dgerb/PicrogridE/README.md

# Picrogrid
Repository for Picrogrid Raspberry Pi code and scripts and Atverter Arduino code
