dgerb/PicrogridE/AtverterE/KiCad/Projects/Atverter_vE1r5/Atverter_vE1r5.kicad_pcb

## KiCad design AtverterE/KiCad/Projects/Atverter_vE1r5/Atverter_vE1r5.kicad_pcb (2022-10-17)

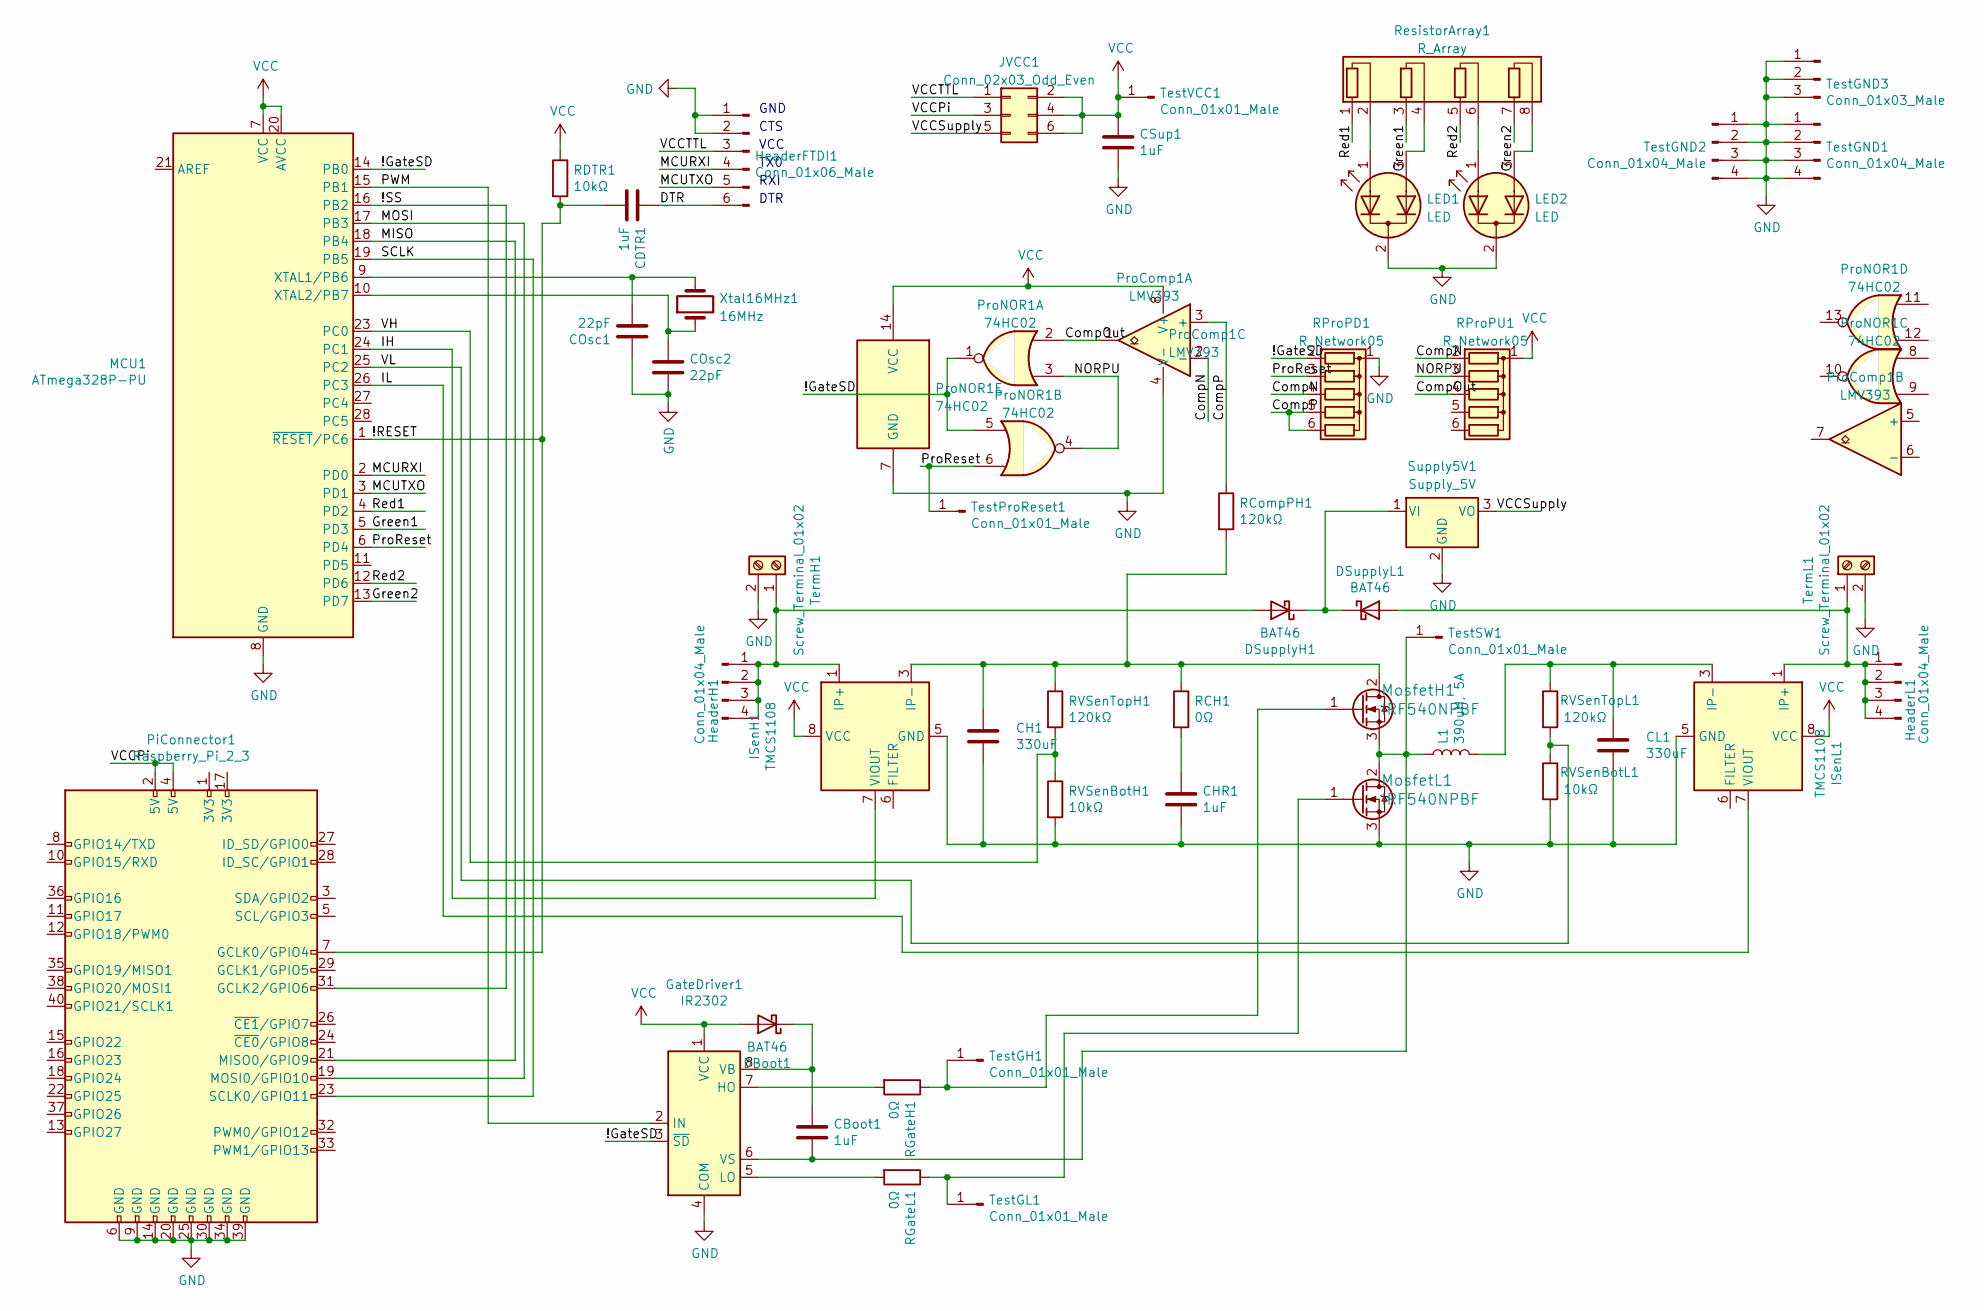
[picture p1: schematic Atverter_vE1r5.kicad_sch]

Parts:
CBoot1: 1uF; C_Rect_L7.2mm_W3.5mm_P5.00mm_FKS2_FKP2_MKS2_MKP2
CDTR1: 1uF; C_Rect_L7.2mm_W3.5mm_P5.00mm_FKS2_FKP2_MKS2_MKP2
CH1: 330uF; CP_Radial_D18.0mm_P7.50mm
CHR1: 1uF; C_Rect_L7.2mm_W3.5mm_P5.00mm_FKS2_FKP2_MKS2_MKP2
CL1: 330uF; CP_Radial_D18.0mm_P7.50mm
COsc1, COsc2: 22pF; C_Rect_L7.2mm_W3.5mm_P5.00mm_FKS2_FKP2_MKS2_MKP2
CSup1: 1uF; C_Rect_L7.2mm_W3.5mm_P5.00mm_FKS2_FKP2_MKS2_MKP2
DBoot1: BAT46; D_DO-35_SOD27_P7.62mm_Horizontal
DSupplyH1: BAT46; D_DO-35_SOD27_P7.62mm_Horizontal
DSupplyL1: BAT46; D_DO-35_SOD27_P7.62mm_Horizontal
GateDriver1: IR2302; DIP-8_W7.62mm_LongPads
HeaderFTDI1: Conn_01x06_Male; FTDI_USB_TTL_Header
HeaderH1: Conn_01x04_Male; PinHeader_1x04_P2.54mm_Vertical
HeaderL1: Conn_01x04_Male; PinHeader_1x04_P2.54mm_Vertical
ISenH1: TMCS1108; SOIC-8_3.9x4.9mm_P1.27mm
ISenL1: TMCS1108; SOIC-8_3.9x4.9mm_P1.27mm
JVCC1: Conn_02x03_Odd_Even; PinHeader_2x03_P2.54mm_Vertical
L1: 390uH, 5A; L_Toroid_Horizontal_D32.5mm_P30.00mm_Bourns_2300
LED1, LED2: LED; LED_3pin_P2.54mm
MCU1: ATmega328P-PU; DIP-28_W7.62mm
MosfetH1: IRF540NPBF; TO-220-3_Vertical; MPN IRF540NPBF; Digi-Key_PN IRF540NPBF-ND
MosfetL1: IRF540NPBF; TO-220-3_Vertical; MPN IRF540NPBF; Digi-Key_PN IRF540NPBF-ND
PiConnector1: Raspberry_Pi_2_3; Raspberry_Pi_Zero_and_Four
ProComp1: LMV393; DIP-8_W7.62mm_LongPads
ProNOR1: 74HC02; DIP-14_W7.62mm_LongPads
RCH1: 0Ω; R_Axial_DIN0207_L6.3mm_D2.5mm_P7.62mm_Horizontal
RCompPH1: 120kΩ; R_Axial_DIN0207_L6.3mm_D2.5mm_P7.62mm_Horizontal
RDTR1: 10kΩ; R_Axial_DIN0207_L6.3mm_D2.5mm_P7.62mm_Horizontal
RGateH1: 0Ω; R_Axial_DIN0207_L6.3mm_D2.5mm_P7.62mm_Horizontal
RGateL1: 0Ω; R_Axial_DIN0207_L6.3mm_D2.5mm_P7.62mm_Horizontal
RProPD1: R_Network05; R_Array_SIP6
RProPU1: R_Network05; R_Array_SIP6
RVSenBotH1: 10kΩ; R_Axial_DIN0207_L6.3mm_D2.5mm_P7.62mm_Horizontal
RVSenBotL1: 10kΩ; R_Axial_DIN0207_L6.3mm_D2.5mm_P7.62mm_Horizontal
RVSenTopH1: 120kΩ; R_Axial_DIN0207_L6.3mm_D2.5mm_P7.62mm_Horizontal
RVSenTopL1: 120kΩ; R_Axial_DIN0207_L6.3mm_D2.5mm_P7.62mm_Horizontal
ResistorArray1: R_Array; R_Array_SIP8
Supply5V1: Supply_5V; SupplyDC_48V-5V_TO-220-3_Vertical
TermH1: Screw_Terminal_01x02; Term_Block_1x2_P5mm
TermL1: Screw_Terminal_01x02; Term_Block_1x2_P5mm
TestGH1: Conn_01x01_Male; PinHeader_1x01_P2.54mm_Vertical
TestGL1: Conn_01x01_Male; PinHeader_1x01_P2.54mm_Vertical
TestGND1, TestGND2: Conn_01x04_Male; PinHeader_1x04_P2.54mm_Vertical
TestGND3: Conn_01x03_Male; PinHeader_1x03_P2.54mm_Vertical
TestProReset1: Conn_01x01_Male; PinHeader_1x01_P2.54mm_Vertical
TestSW1: Conn_01x01_Male; PinHeader_1x01_P2.54mm_Vertical
TestVCC1: Conn_01x01_Male; PinHeader_1x01_P2.54mm_Vertical
Xtal16MHz1: 16MHz; Resonator-2Pin_W10.0mm_H5.0mm

Connections:
/!GateSD: GateDriver1.3 (~SD), MCU1.14 (PB0), ProNOR1.1, ProNOR1.5, RProPD1.2 (R1)
/!RESET: CDTR1.2, MCU1.1 (~RESET/PC6), PiConnector1.7 (GCLK0/GPIO4), RDTR1.2
/!SS: MCU1.16 (PB2), PiConnector1.31 (GCLK2/GPIO6)
/CompN: ProComp1.2 (-), RProPD1.4 (R3), RProPU1.2 (R1)
/CompOut: ProComp1.1, ProNOR1.2, RProPU1.4 (R3)
/CompP: ProComp1.3 (+), RCompPH1.1, RProPD1.5 (R4), RProPD1.6 (R5); also elsewhere on the board
/DTR: CDTR1.1, HeaderFTDI1.6
/Green1: MCU1.5 (PD3), ResistorArray1.3 (R2.1)
/Green2: MCU1.13 (PD7), ResistorArray1.7 (R4.1)
/IH: ISenH1.7 (VIOUT), MCU1.24 (PC1)
/IL: ISenL1.7 (VIOUT), MCU1.26 (PC3)
/MCURXI: HeaderFTDI1.4, MCU1.2 (PD0)
/MCUTXO: HeaderFTDI1.5, MCU1.3 (PD1)
/MISO: MCU1.18 (PB4), PiConnector1.21 (MISO0/GPIO9)
/MOSI: MCU1.17 (PB3), PiConnector1.19 (MOSI0/GPIO10)
/NORPU: ProNOR1.3, ProNOR1.4, RProPU1.3 (R2)
/PWM: GateDriver1.2 (IN), MCU1.15 (PB1)
/ProReset: MCU1.6 (PD4), ProNOR1.6, RProPD1.3 (R2), TestProReset1.1
/Red1: MCU1.4 (PD2), ResistorArray1.1 (R1.1)
/Red2: MCU1.12 (PD6), ResistorArray1.5 (R3.1)
/SCLK: MCU1.19 (PB5), PiConnector1.23 (SCLK0/GPIO11)
/VCCPi: JVCC1.3, PiConnector1.2 (5V), PiConnector1.4 (5V)
/VCCSupply: JVCC1.5, Supply5V1.3 (VO)
/VCCTTL: HeaderFTDI1.3, JVCC1.1
/VH: MCU1.23 (PC0), RVSenBotH1.1, RVSenTopH1.2
/VL: MCU1.25 (PC2), RVSenBotL1.1, RVSenTopL1.2
GND: CH1.2, CHR1.2, CL1.2, COsc1.1, COsc2.2, CSup1.2, GateDriver1.4 (COM), HeaderFTDI1.1, HeaderFTDI1.2, ISenH1.5 (GND), ISenL1.5 (GND), LED1.2 (K), LED2.2 (K), MCU1.8 (GND), MCU1.22 (GND), MosfetL1.3 (S), PiConnector1.6 (GND), PiConnector1.9 (GND), PiConnector1.14 (GND), PiConnector1.20 (GND), PiConnector1.25 (GND), PiConnector1.30 (GND), PiConnector1.34 (GND), PiConnector1.39 (GND), ProComp1.4 (V-), ProNOR1.7 (GND), RProPD1.1 (common), RVSenBotH1.2, RVSenBotL1.2, Supply5V1.2 (GND), TermH1.2, TermL1.2, TestGND1.1, TestGND1.2, TestGND1.3, TestGND1.4, TestGND2.1, TestGND2.2, TestGND2.3, TestGND2.4, TestGND3.1, TestGND3.2, TestGND3.3
unnamed: CBoot1.1, DBoot1.1 (K), GateDriver1.8 (VB)
unnamed: CBoot1.2, GateDriver1.6 (VS), L1.1, MosfetH1.3 (S), MosfetL1.2 (D), TestSW1.1
unnamed 29: CH1.1, ISenH1.3 (IP-), ISenH1.4 (IP-), MosfetH1.2 (D), RCH1.1, RCompPH1.2, RVSenTopH1.1; also elsewhere on the board
unnamed: CHR1.1, RCH1.2
unnamed: CL1.1, ISenL1.3 (IP-), ISenL1.4 (IP-), L1.2, RVSenTopL1.1
unnamed: COsc1.2, MCU1.9 (XTAL1/PB6), Xtal16MHz1.2
unnamed: COsc2.1, MCU1.10 (XTAL2/PB7), Xtal16MHz1.1
unnamed: DSupplyH1.1 (K), DSupplyL1.1 (K), Supply5V1.1 (VI)
unnamed: DSupplyH1.2 (A), HeaderH1.1, HeaderH1.2, HeaderH1.3, HeaderH1.4, ISenH1.1 (IP+), ISenH1.2 (IP+), TermH1.1
unnamed: DSupplyL1.2 (A), HeaderL1.1, HeaderL1.2, HeaderL1.3, HeaderL1.4, ISenL1.1 (IP+), ISenL1.2 (IP+), TermL1.1
unnamed: GateDriver1.5 (LO), RGateL1.2
unnamed: GateDriver1.7 (HO), RGateH1.2
unnamed: LED1.1 (A1), ResistorArray1.2 (R1.2)
unnamed: LED1.3 (A2), ResistorArray1.4 (R2.2)
unnamed: LED2.1 (A1), ResistorArray1.6 (R3.2)
unnamed: LED2.3 (A2), ResistorArray1.8 (R4.2)
unnamed: MosfetH1.1 (G), RGateH1.1, TestGH1.1
unnamed: MosfetL1.1 (G), RGateL1.1, TestGL1.1
VCC: CSup1.1, DBoot1.2 (A), GateDriver1.1 (VCC), ISenH1.8 (VCC), ISenL1.8 (VCC), JVCC1.2, JVCC1.4, JVCC1.6, MCU1.7 (VCC), MCU1.20 (AVCC), ProComp1.8 (V+), ProNOR1.14 (VCC), RDTR1.1, RProPU1.1 (common), TestVCC1.1

Notes on the sheet:
RXI
GND
VCC
TX0
DTR
CTS

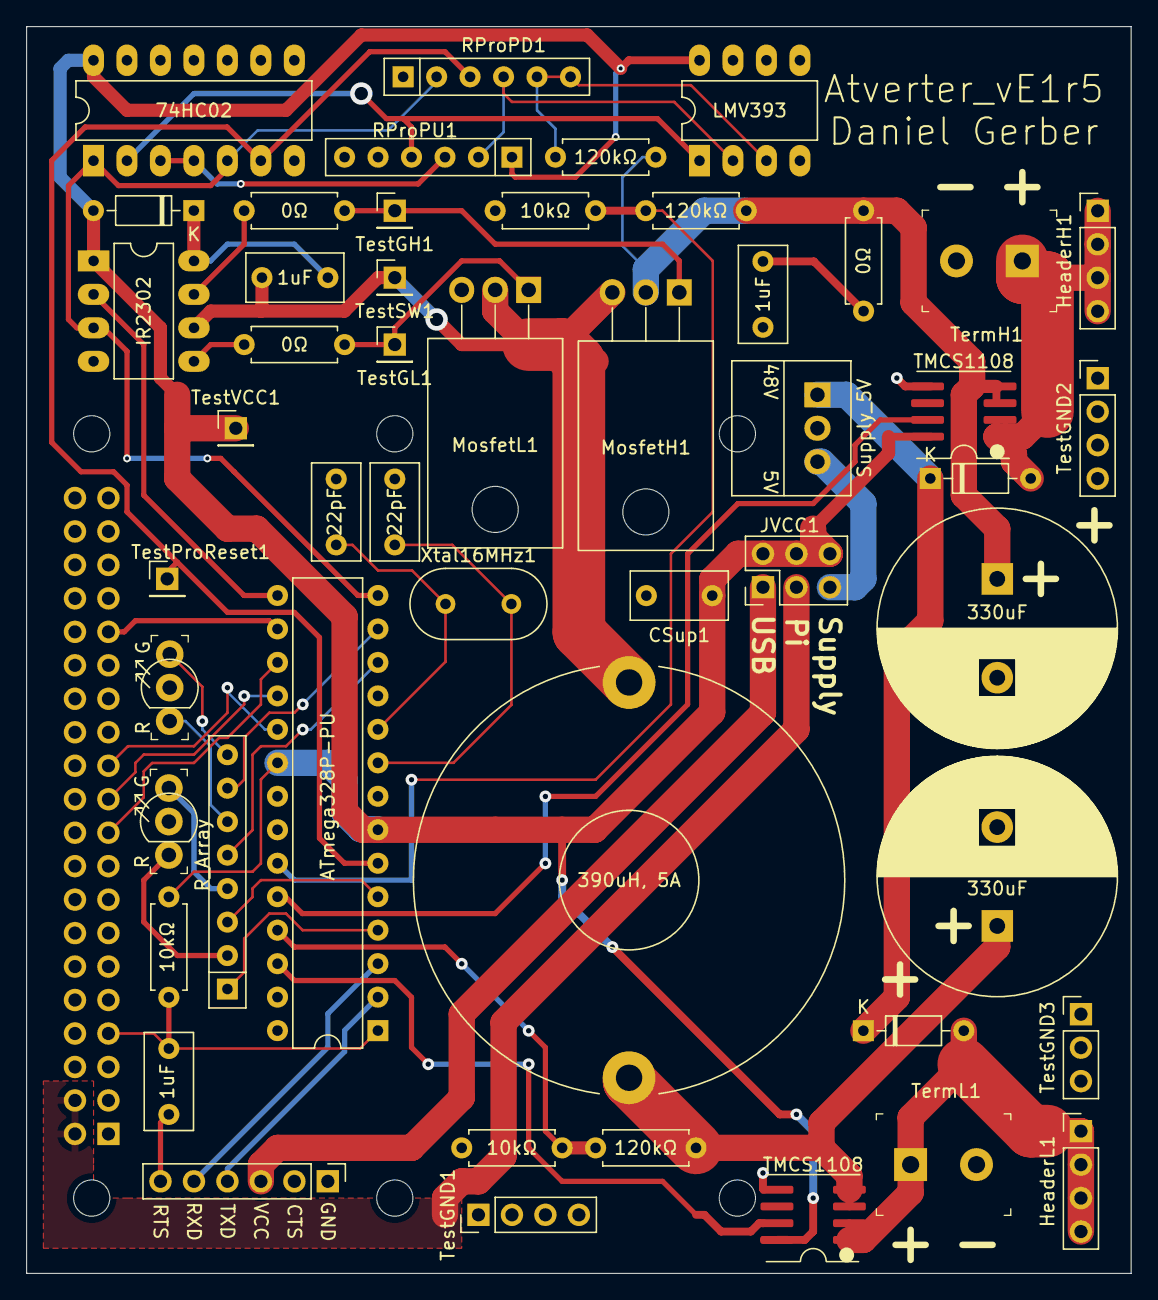
[picture p2: board Atverter_vE1r5.kicad_pcb from above]

Board: 2 copper layers, 83.8 x 94.6 mm, 51 parts (1 on the bottom side), 46 nets.

Other parts of the board:
locked: 120kΩ; R_Axial_DIN0207_L6.3mm_D2.5mm_P7.62mm_Horizontal

Their connections:
/CompP: locked.1; also elsewhere on the board
unnamed 29: locked.2; also elsewhere on the board
