dgerb/PicrogridE/Raspberry Pi Files/serial_signals.py

from time import sleep
import json
import serial 



#serial setup
#check that you have the right serial port with ls /dev/tty* in the Pi's terminal
#unplug your port and see which one disappears
ser = serial.Serial('/dev/ttyACM0', 115200, timeout = 1.0)
sleep(3)
ser.reset_input_buffer()

#actual program
minprice = 0
maxprice = 1
minbinary = 0
maxbinary = 63


#import JSON file already on Pi
# make sure the file is on the Pi with the right name
with open ("powerdata.json") as file:
	data = json.load(file)
dailydata = data.get("intervals")[0].get("payloads")[0].get("values")

#like the arduino map() function, convert value to a new range
def map_to_value(input_value, input_min, input_max, output_min, output_max):
	val1 = ((input_value - input_min)/(input_max - input_min))
	output_value = (val1 * (output_max - output_min)) + output_min
	return output_value

def map_to_binary(input_val):
	binary = map_to_value(input_val, minprice, maxprice, minbinary, maxbinary)
	return round(binary)

def convert_to_push(pricelist):
	binary_code_list = []
	for price in pricelist:
		pushcode = (map_to_binary(price))
		binary_code_list.append(pushcode)
	return binary_code_list

def rpi_output(list_of_lists):
    try:
        for price in list_of_lists:
            sleep(0.1)
            ser.write((price + '\n').encode('utf-8'))
            sleep(5)
			if ser.in_waiting > 0:
				line = ser.readline().decode('utf-8')
				print(line)
    except KeyboardInterrupt:
        ser.close()


data = convert_to_push(dailydata)
rpi_output(data)

#ser.close()
