dgerb/PicrogridE/(commit log)

2022-09-21 added PWM, pro reset, untested vh ih vl il, PWMTest example
    [Blink.ino, PWMTest.ino]
2022-10-04 added KiCad PCB v1r4
    [Atverter_Ev1r4-B_Mask.gbs, Atverter_Ev1r4-B_Paste.gbp, Atverter_Ev1r4-B_Silkscreen.gbo, Atverter_Ev1r4-Back.gbl, Atverter_Ev1r4-Edge_Cuts.gm1, Atverter_Ev1r4-F_Mask.gts, Atverter_Ev1r4-F_Paste.gtp, Atverter_Ev1r4-F_Silkscreen.gto]
2022-10-17 added kicad files for Atverter_vE1r5, cleaned up library
    [Atverter_Ev1r4-B_Mask.gbs, Atverter_Ev1r4-B_Paste.gbp, Atverter_Ev1r4-B_Silkscreen.gbo, Atverter_Ev1r4-Back.gbl, Atverter_Ev1r4-Edge_Cuts.gm1, Atverter_Ev1r4-F_Mask.gts, Atverter_Ev1r4-F_Paste.gtp, Atverter_Ev1r4-F_Silkscreen.gto]
2022-11-16 added digikey BOM
    [BOM_Digikey_2x.csv]
2023-01-26 Current and Voltage Control Code
2023-01-27 Fixed Compile error
    Line 32 added parenthesis to properly call function
    [Current_Controller_Buck.ino]
2023-02-02 Current Controller
    Updated Current Controller and started Battery charging and voltage controller (Boost)
2023-02-08 Updated Voltage Controller
    Added Smoothing controls to maintain output voltage when desired value is pinpointed
2023-02-15 Updated Voltage_Controller_Buck
    Added Some more smoothing controller but still need to fix and add in a moving average to made the smoothing controller better
    [Voltage_Controller_Buck.ino]
2023-02-22 Added averaging filter
2023-03-03 Buck Controller update
    - Refactored the code to make it more modular and readable
    - Implemented error equation to jump to correct duty cycle
    - Implemented moving average filter to maintain steady output voltage
    - Refactored code can now sample at 1ms
    [Voltage_Controller_Buck.ino]
2023-03-06 Buck Voltage control and Buck Current control
    Added calibration to the buck controller
    Current controller a better plan is needed to smooth out the output
2023-03-09 Voltage controller and current controller fixes
    [Current_Controller_Buck.ino, Voltage_Controller_Buck.ino]
2023-03-09 Sensor Characterization added
    Added test file to characterize the voltage and current sensors
2023-03-09 Finished updating voltage sensors
2023-03-09 Updated Voltage Controller Buck
    Added the sensor fixes
    [Voltage_Controller_Buck.ino]
2023-03-15 Voltage Controller, Current Controller, and Sensor Additions
    Voltage Controller_Buck: Finished Tweaking it
    Current Controller: Code finished but needs some tweaking and more sensor characterization so it works across many voltages.
2023-04-12 Voltage Controller Buck and current controller fixes
    Made the voltage controller more of a critically damped oscillator (less ringing).
    Current controller: Finalized the characteristics of the current controller. Code for actual current controller doesn't work at the moment. Resolution is strange and the jumps in current values is a very large jump so need to fix that issue.
    [Current_Controller_Buck.ino, Sensor_Characterization.ino, Voltage_Controller_Buck.ino]
2023-04-20 Current and Voltage fixes
    [Current_Controller_Buck.ino, Voltage_Controller_Buck.ino]
2023-04-26 Voltage Controller Boost code started
    Battery_Charging: Now that current and voltage controllers done can focus on adding to battery charge code
    Current and voltage controllers tweaked a bit and added sensor data for second atverterE board
    Voltage controller boost: started this code needs some others eyes to look at but idea works so far but very jumpy
2023-05-04 header and source file for voltage controller
2023-05-25 Added PI controller to Boost and Buck and Main
2023-05-25 Added PI control to Main file as well as current control and buck individually
    Still have to add current contorl to the Main file
2023-05-29 Updated flows and changed main
2023-05-29 added current control state but no logic yet
2023-05-29 Update Buck control system
    Captured pictures and added steady state error
    [Main.ino]
2023-05-31 Final updates
    Characterized last Atverter sensors
    Updated flow for server
    Added current control to main file
2023-06-22 Update and rename BOM_Digikey_2x.csv to BOM_vE1r5_Digikey_2x.csv
    [BOM_vE1r5_Digikey_2x.csv]
2023-06-23 Upload with two paths to output
    Some comments contain a method for determining the current the atverter should be drawing. Those current numbers are not necessary to determine output bit code, but can be uncommented to match current levels with output bits.
2023-06-26 added JSON functionality and changed GPIO pin
2023-07-03 Arduino serial code to go with serial_testing
    for sim only
2023-08-03 finalized PWM constraints
